aqueelahmad/PlasticScanner/Hardware/README.md

# Do not build the current PCB, it has flaws

## printed circuit board
PCB design can be found [here](https://easyeda.com/jerzeek/nir-spectroscope-final-pcb)

## Enclosure
Enclosure design can be found [here](https://a360.co/2Nr8VwX), and can be 3D printed

## Mechanical drawings
Mechanical drawing still need to be added to make production easier ;)
