aqueelahmad/PlasticScanner/Hardware/PCB/BOM.csv

ID | Name | Designator | Footprint | Quantity | Manufacturer Part | Manufacturer | Supplier | Supplier Part | _Price | LCSC Assembly
1 | Molex 0524651071 | U9 | 0524651071 MOLEX | 1 | 0524651071 | Molex | Digi-Key | WM8918CT-ND
2 | IC - 74HC238PW - DEMULTIPLEXER | U6 | TSSOP-16_L5.0-W4.4-P0.65-LS6.4-BL | 1 | 74HC238PW,118 | Nexperia | LCSC | C60434 | $0.2704 | Yes
3 | 1206 LED | D8,D7,D6,D5,D9,D3,D2,D4 | 1206 SMD LED | 8
4 | HDR-F-2.54_1x6 | H3 | HDR-F-2.54_1X6 | 1 |  |  | LCSC | C40877 | $0.0575
5 | 100 | R21,R8,R7,R23,R22,R12 | C0805 | 6
6 | 240k | R6,R5 | C0805 | 2
7 | 49.9 | R1,R2 | C0805 | 2
8 | 43 | R13,R14,R15,R16,R17 | C0805 | 5
9 | 39 | R18 | C0805 | 1
10 | 36 | R19 | C0805 | 1
11 | 6.8 | R20 | C0805 | 1
12 | 0 | R25,R24 | C0805 | 2
13 | 1K | R26 | C0805 | 1
14 | 301 | R3,R4 | C0805 | 2
15 | 100k | R9,R10,R11 | C0805 | 3
16 | HDR-M-2.54_2x4 | J1 | HDR-M-2.54_2X4 | 1 |  |  | LCSC | C58363 | $0.027342
17 | ESP32 | U10 | ESP32 MODULE | 1
18 | 100uH | L1 | IND-SMD_L6.0-W6.0_ASPI-6045S | 1 | ASPI-6045S-101M-T | Abracon LLC | LCSC | C187467 | $0.5391
19 | 0TF | L2 | L0805 | 1 | PZ2012U221-2R0TF | Sunlord | LCSC | C44361 | $0.0225 | Yes
20 | LED | PHOTODIODE | CHIPLED_1206 | 1
21 | 8MHz | X1 | HC-49S | 1 | HC-49S 8MHz 20pF 30PPM | TAE | LCSC | C107425 | $0.0726
22 | 51p | C9,C8 | C0805 | 2
23 | 100n | C17,C1,C13,C14,C4 | C0805 | 5
24 | 18p | C19,C18 | C0805 | 2
25 | 100P | C10 | C0805 | 1
26 | 47n | C11,C7,C12 | C0805 | 3
27 | 22u | C5,C15 | C0805 | 2
28 | 47u | C6 | C0805 | 1
29 | 100u | C2 | C0805 | 1
30 | 100p | C3 | C0805 | 1
31 | 1N5817W | D1 | SOD-123_L2.8-W1.8-LS3.7-RD | 1 | 1N5817W | TWGMC | LCSC | C727113 | $0.019963 | Yes
32 | HDR-M-2.54_1x2 | J3 | HDR-M-2.54_1X2 | 1 |  |  | LCSC | C124375 | $0.0159
33 | HT7750 | U4 | SOT-89-3_L4.5-W2.5-P1.50-LS4.2-BR | 1 | HT7750 | Holtek Semicon | LCSC | C259541 | $0.1689
34 | QWIIC_CONNECTORJS-1MM | J2 | JST04_1MM_RA | 1
35 | Molex 0533071071 | U7 | 0533071071 MOLEX | 1 | 0533071071 | Molex | Digi-Key | WM8918CT-ND
36 | ADS1256IDBR | U1 | SSOP-28_L10.2-W5.3-P0.65-LS7.8-BL | 1 | ADS1256IDBR | TI | LCSC | C28186 | $7.9596 | Yes
37 | LM285D-2.5G | U2 | SOIC-8_L4.9-W3.9-P1.27-LS6.0-BL | 1 | LM285D-2.5G | ON Semicon | LCSC | C480796 | $0.748485 | Yes
38 | SI1922EDH-T1-GE3 | Q1,Q3,Q4,Q2 | SC-70-6_L2.2-W1.3-P0.65-LS2.2-BL | 4 | SI1922EDH-T1-GE3 | VISHAY | LCSC | C141538 | $0.6951 | Yes
39 | HDR-F-2.54_2x4 | H1 | HDR-F-2.54_2X4 | 1 |  |  | LCSC | C239344 | $0.1815
40 | HDR-F-2.54_1x4 | H2 | HDR-F-2.54_1X4 | 1 |  |  | LCSC | C225501 | $0.0905
41 | OPA2376QDGKRQ1 | U3 | VSSOP-8_L3.0-W3.0-P0.65-LS5.0-BL | 1 | OPA2376QDGKRQ1 | Texas Instruments | LCSC | C201756 | $3.7088
