aqueelahmad/PlasticScanner/Hardware/Enclosure/Enclosure v1.step

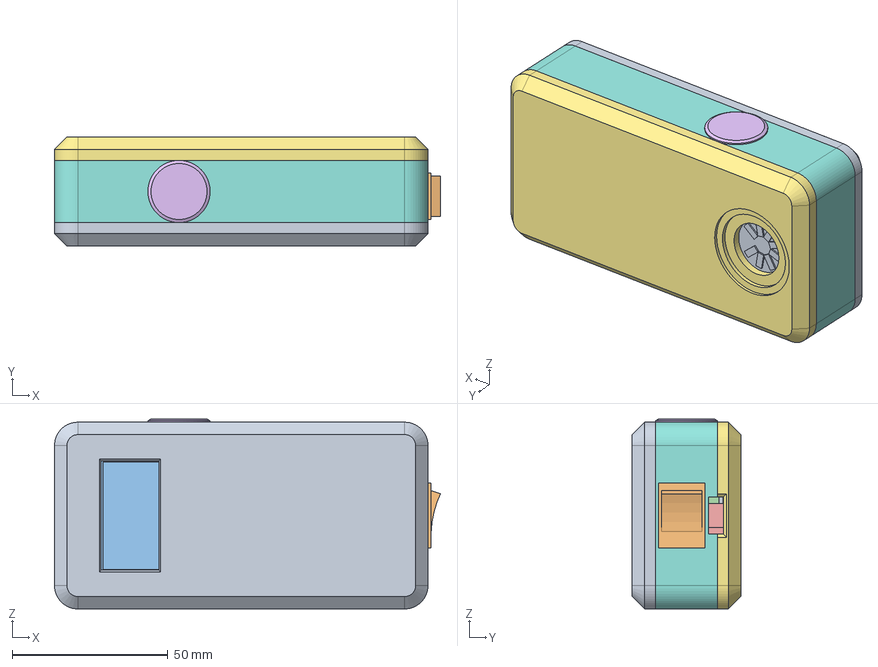
[picture p3: CAD file, 2021-01-27]
Hardware/Enclosure/Enclosure v1.step
124.0 x 35.0 x 61.0 mm
PCB Sensor
Pi zero
screen
battery
charger
button
top
middle
bottom
switch
