aqueelahmad/PlasticScanner/Hardware/PCB/Schematic.pdf

## 2.5v ref

## ADC

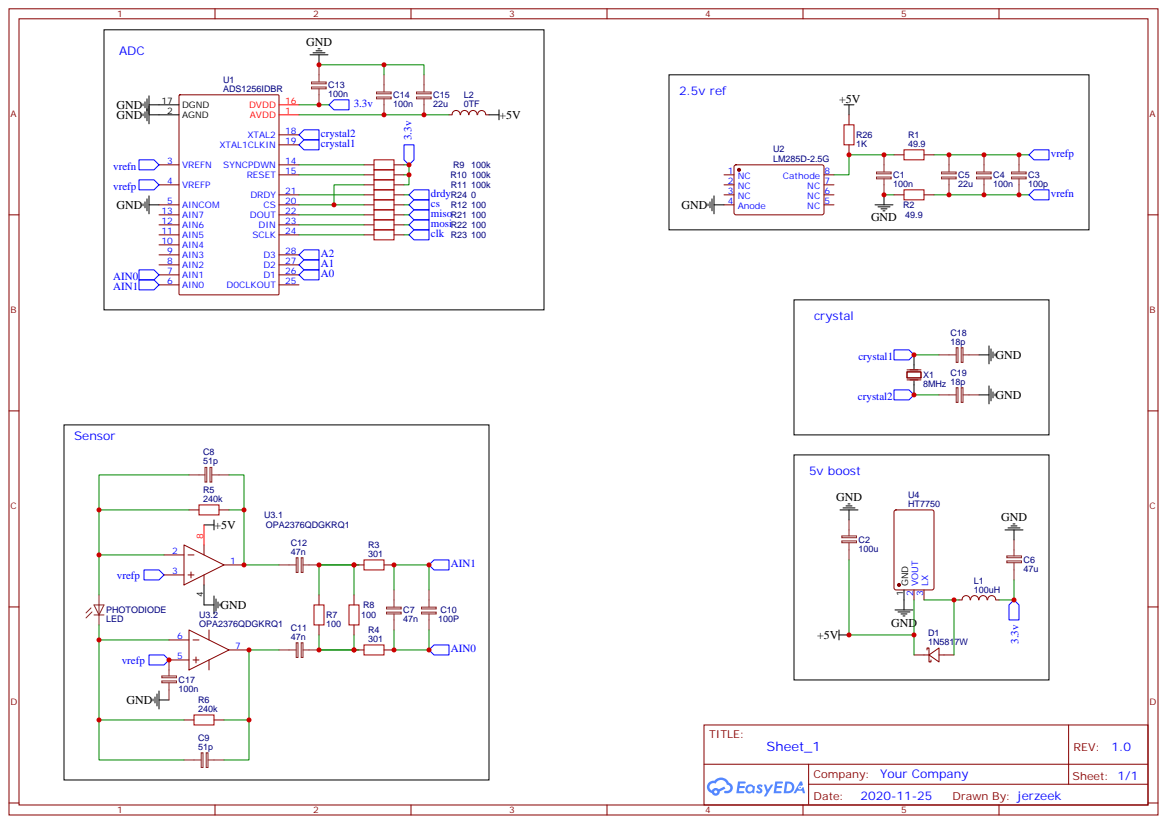
[picture p4: page 1]

# Y5 10 Y4 11 Y3 12 Y2 13 Y1 14 Y0 15 VCC 16

## Light

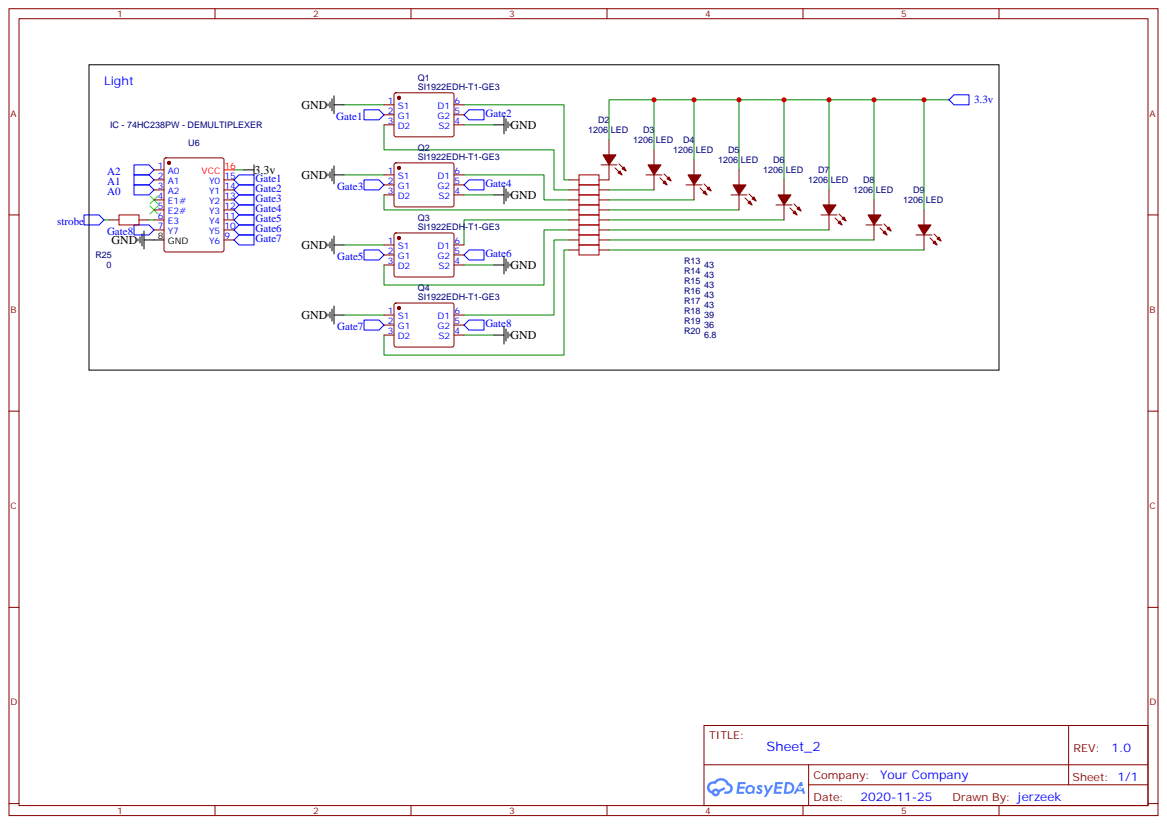
[picture p5: page 2]

## connector

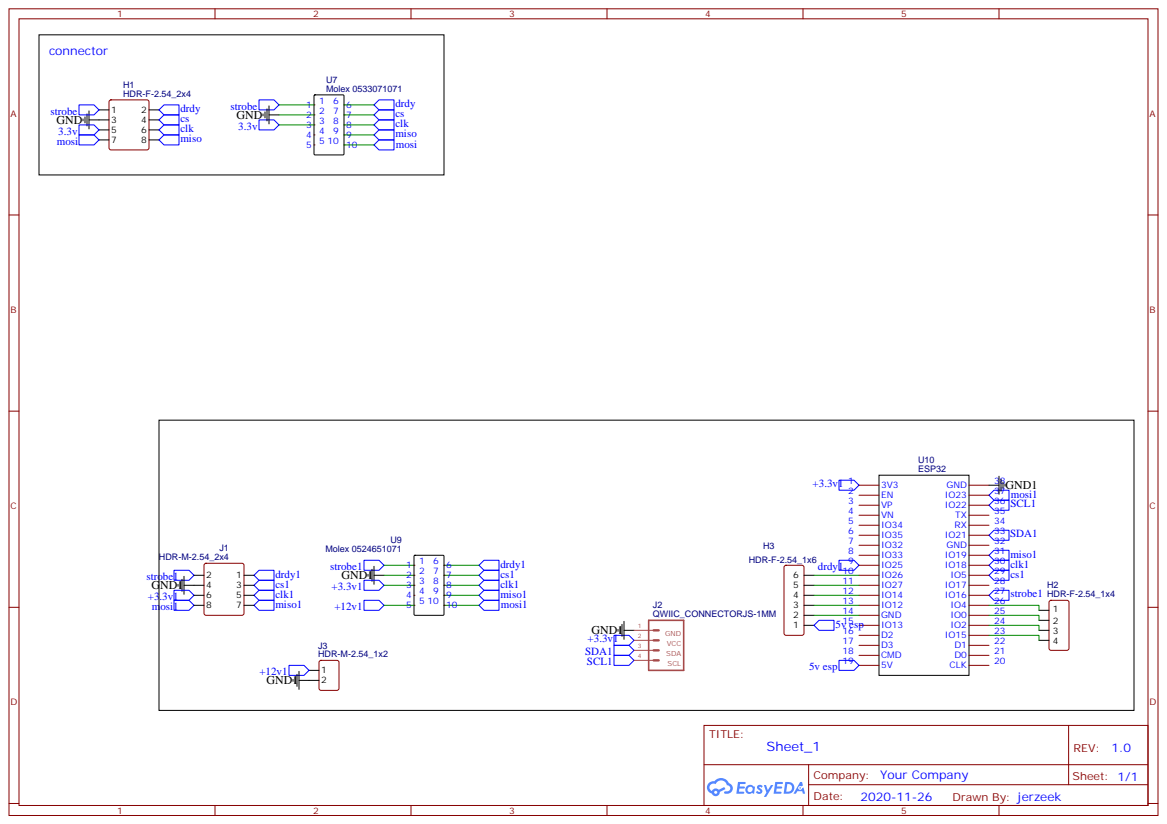
[picture p6: page 3]
