aqueelahmad/PlasticScanner/Software/codeForMK1/simulation/pwm-highpass.asc

C1: cap; 100n
C2: cap; 100n
C3: cap; 4800p
R1: res; 301
R2: res; 301
R3: res; 1100
V1: voltage; SINE(1 1 100 0 0 0 10)
Named nets: 0
.tran 0 10mS 0
