aqueelahmad/PlasticScanner/Software/MachineLearningModel/test_data.csv

PlasticType | wavelength1 | wavelength2 | wavelength3 | wavelength4 | wavelength5 | wavelength6 | wavelength7 | wavelength8 | wavelength9 | wavelength10 | wavelength11 | wavelength12 | wavelength13 | wavelength14
1 | 30915 | 433389 | 661724 | 323544 | 364840 | 252345 | 284474 | 111988 | 2537.0555555555557 | -1300.6923076923076 | 412.96 | -749.9666666666667 | 321.29 | -1724.86
2 | 25863 | 466326 | 739402 | 337455 | 419472 | 318053 | 389461 | 179100 | 3034.177777777778 | -1545.95 | 820.17 | -676.1266666666667 | 714.08 | -2103.61
5 | 25843 | 456908 | 753197 | 381459 | 464465 | 349047 | 403808 | 172368 | 3292.1 | -1429.7615384615385 | 830.06 | -769.4533333333334 | 547.61 | -2314.4
6 | 31871 | 539278 | 892158 | 410135 | 499354 | 333604 | 367334 | 160316 | 3920.8888888888887 | -1853.9346153846154 | 892.19 | -1105.0 | 337.3 | -2070.18
