aqueelahmad/PlasticScanner/(commit log)

2020-12-07 sample data 7 december
    [testresults.csv, testresults_07dec.csv]
2020-12-14 wrote readme, opening up repo
    [sample_data.csv, test_data.csv]
2020-12-25 machine learning attempt
    [sample_data.csv, test_data.csv, testresults.csv, testresults_07dec (conflicted copy 2020-12-14 143636).csv, testresults_07dec.csv]
2021-01-07 added individual led control using ADS1256 IOs
2021-01-07 commented PWM section, commentd IO control
2021-01-07 added LT Spice Simulation for Bandpass Filter
2021-01-12 propper led table
2021-01-13 added modulation, ADC settings require changes
2021-01-13 changed to permanent measurment and PWM on 12
2021-01-13 chip_id was not working
    [Plastic_Sense_Functions.py]
2021-01-13 fixed pinout
    [testresults.csv]
2021-01-14 written collection script and estimation front, still need to get tflite working
    [testresults_07dec (conflicted copy 2020-12-14 143636).csv]
2021-01-17 added multiple sample measurement and mean
2021-01-21 restructured files and gave the readmes a revamp
    [BOM.csv, Enclosure v1.step, sample_data.csv, test_data.csv, testresults.csv, testresults_07dec.csv]
2021-01-27 Cleaned repo and improved software README
    [sample_data.csv, test_data.csv, testresults.csv, testresults_07dec.csv]
